p-v-o-s/olm-pstat/README.md

Potentiostat module for the Open Lab Monitor
