p-v-o-s/olm-pstat/test/JSpstat_10k_2probe.csv

#Starting Voltage (mV-1800mV)
#1800.00
#Ending Voltage (mV-1800mV)
#0.00
#Scan Rate in mV/sec (sec)
#100
#Pre-concentration time (sec)
#1
#Mode (0:ASV, 1:CV)
#2
#&
0.0355 | 0.0000
0.0198 | 0.0000
0.0216 | 0.0000
0.0224 | 0.0000
0.0233 | 0.0000
0.0276 | 0.0000
0.0042 | 0.0000
0.0077 | 0.0000
0.0146 | 0.0000
-0.0106 | 0.0000
-0.0097 | 0.0000
-0.0184 | 0.0000
-0.0262 | 0.0000
-0.0141 | 0.0000
-0.0184 | 0.0000
-0.0332 | 0.0000
-0.0349 | 0.0000
-0.0349 | 0.0000
-0.0427 | 0.0000
-0.0427 | 0.0000
-0.0575 | 0.0000
-0.0627 | 0.0000
-0.0532 | 0.0000
-0.0627 | 0.0000
-0.0523 | 0.0000
-0.0618 | 0.0000
-0.0705 | 0.0000
-0.0627 | 0.0000
-0.0792 | 0.0000
-0.0827 | 0.0000
-0.0940 | 0.0000
-0.0853 | 0.0000
-0.0957 | 0.0000
-0.0948 | 0.0000
-0.0992 | 0.0000
-0.1018 | 0.0000
-0.1053 | 0.0000
-0.0966 | 0.0000
-0.0992 | 0.0000
-0.1140 | 0.0000
-0.1244 | 0.0000
-0.1053 | 0.0000
-0.1183 | 0.0000
-0.1339 | 0.0000
-0.1270 | 0.0000
-0.1270 | 0.0000
-0.1435 | 0.0000
-0.1383 | 0.0000
-0.1400 | 0.0000
-0.1591 | 0.0000
-0.1643 | 0.0000
-0.1522 | 0.0000
-0.1695 | 0.0000
-0.1626 | 0.0000
-0.1722 | 0.0000
-0.1617 | 0.0000
-0.1748 | 0.0000
-0.1826 | 0.0000
-0.1678 | 0.0000
-0.1765 | 0.0000
-0.1756 | 0.0000
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
