p-v-o-s/olm-pstat/test/data/out.png

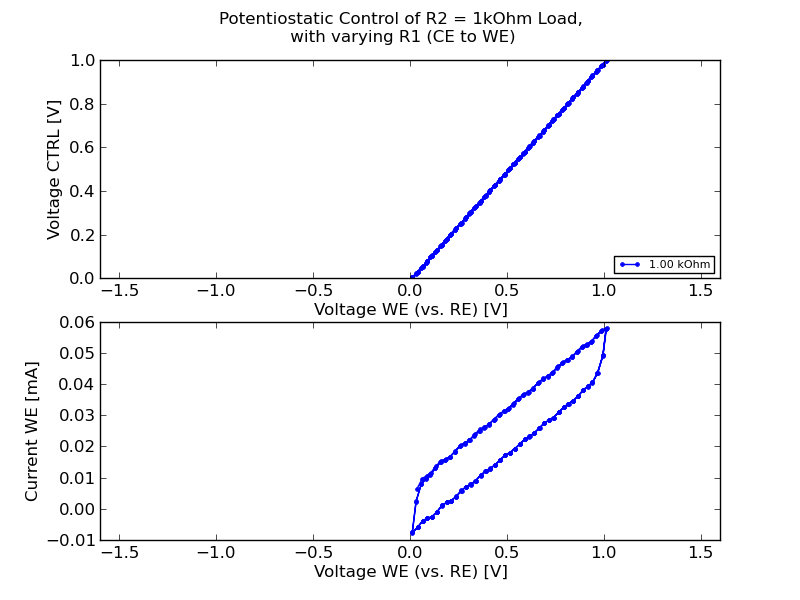
test/data/out.png
