p-v-o-s/olm-pstat/test/data/pstat_R2=1k_R1=0-2k.png

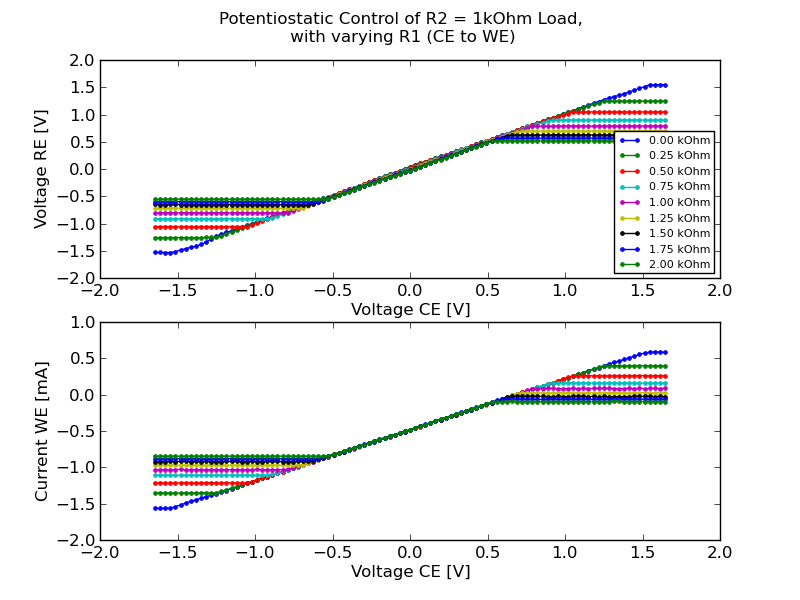
test/data/pstat_R2=1k_R1=0-2k.png
