p-v-o-s/olm-pstat/test/JSpstat_10k_2probe.png

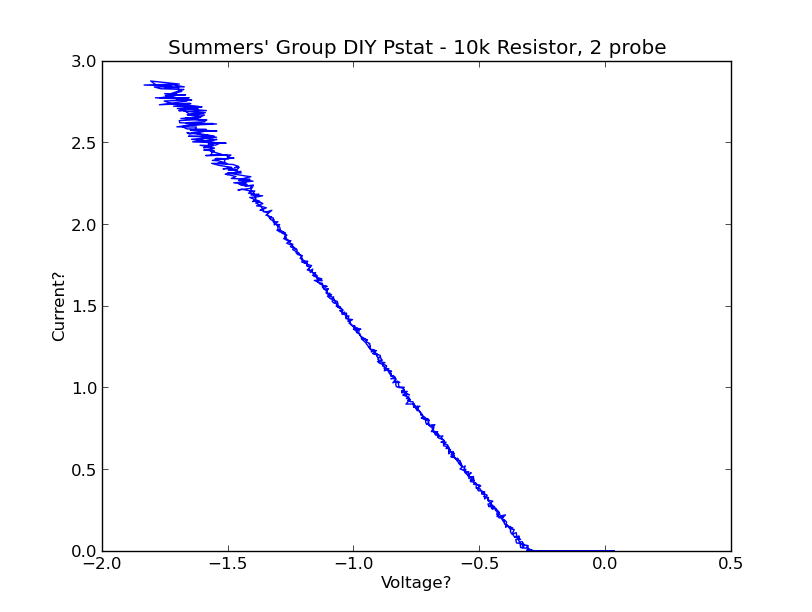
test/JSpstat_10k_2probe.png
