p-v-o-s/olm-pstat/test/MCP4161-104E-P_Resistance_vs_Ntap.png

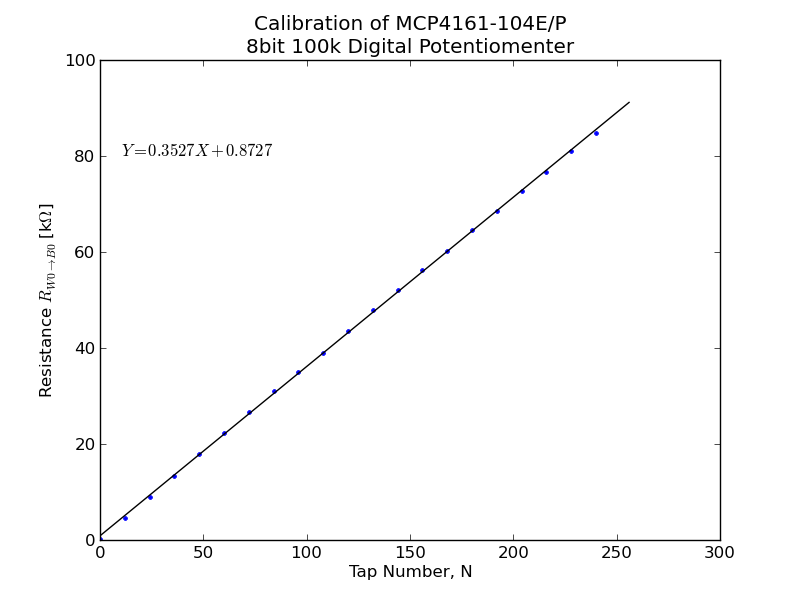
test/MCP4161-104E-P_Resistance_vs_Ntap.png
