p-v-o-s/olm-pstat/test/data/out.pdf

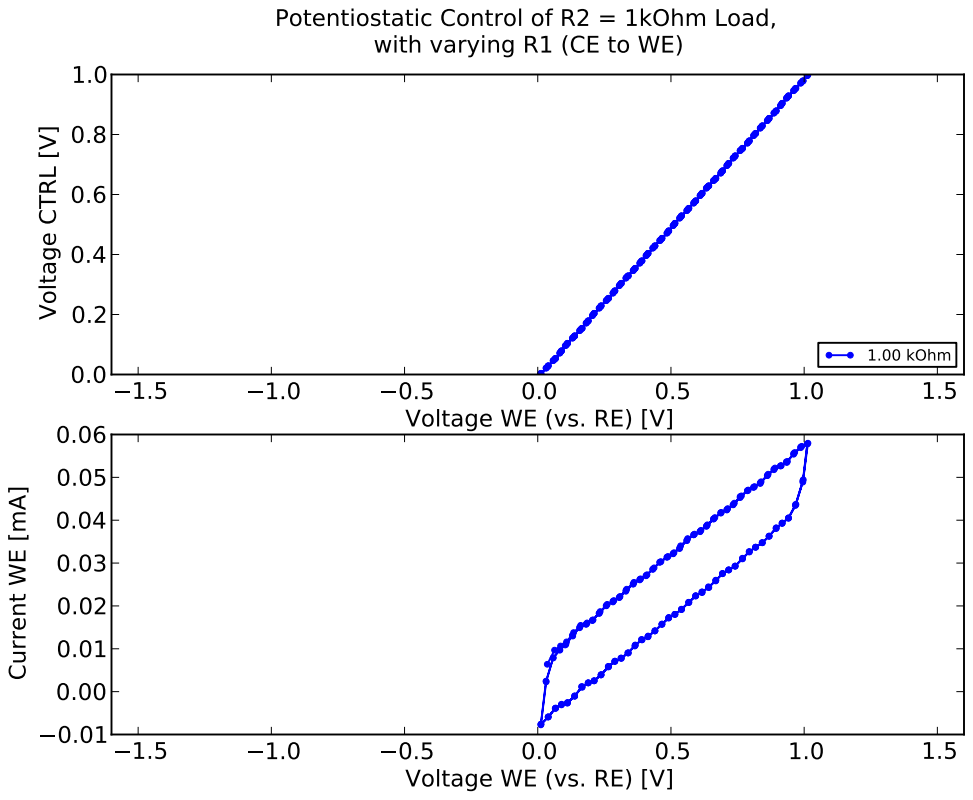
[picture p8: page 1]
Voltage CTRL [V]; 1.00 kOhm

Potentiostatic Control of R2 = 1kOhm Load,

with varying R1 (CE to WE)

Voltage WE (vs. RE) [V]

Current WE [mA]
