p-v-o-s/olm-pstat/test/data/pstat_R2=1k_R1=0-2k.pdf

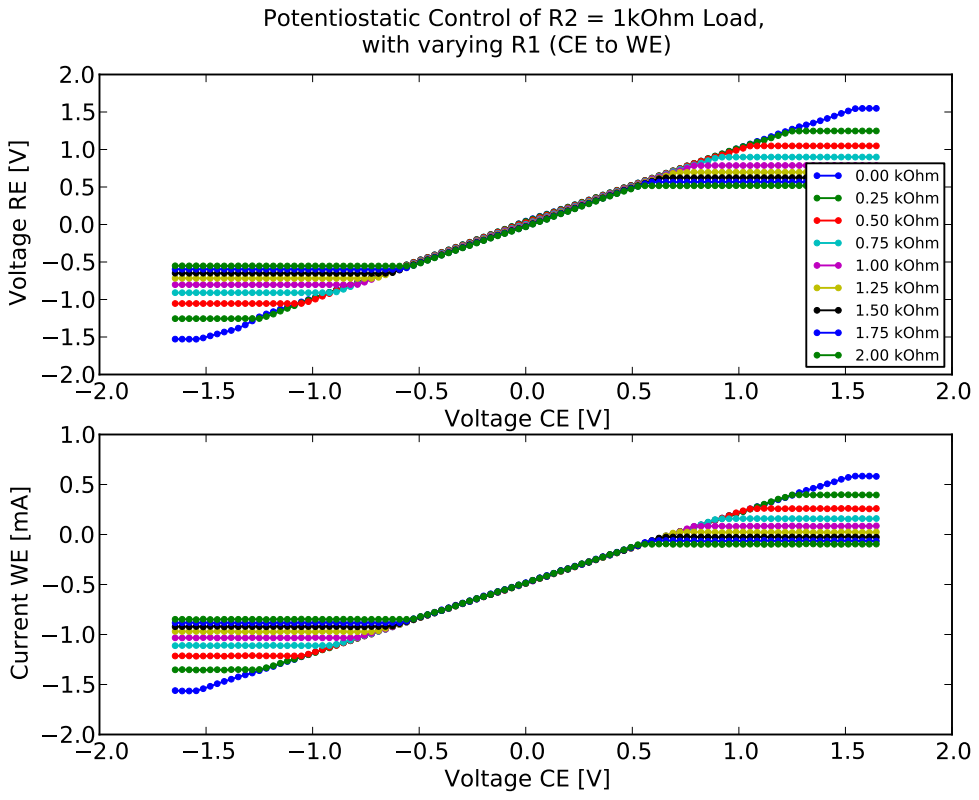
[picture p9: page 1]
Voltage CE [V]; Voltage RE [V]; 0.00 kOhm; 0.25 kOhm; 0.50 kOhm; 0.75 kOhm; 1.00 kOhm; 1.25 kOhm; 1.50 kOhm; 1.75 kOhm; 2.00 kOhm

Potentiostatic Control of R2 = 1kOhm Load,

with varying R1 (CE to WE)

Current WE [mA]
