p-v-o-s/olm-pstat/doc/jsummers/PDIP-Potentiostat-14.brd

## EAGLE design doc/jsummers/PDIP-Potentiostat-14.brd (2013-08-27)

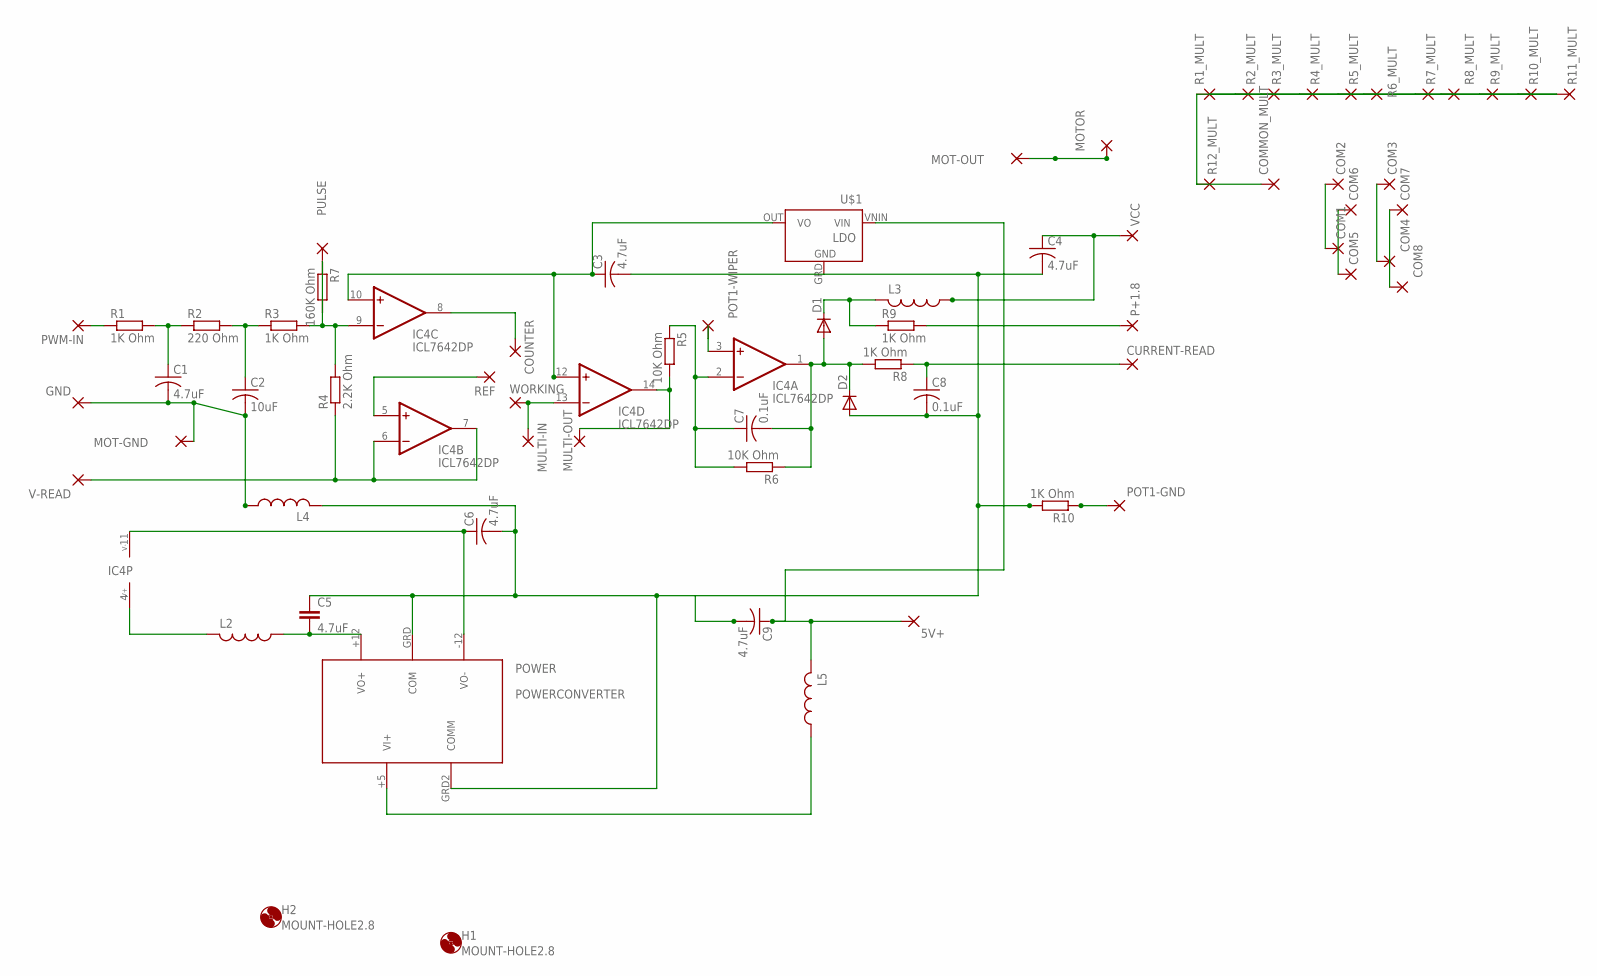
[picture p12: schematic PDIP-Potentiostat-14.sch]

Parts:
5V+: 1,6/0,9
C1, C3, C4, C5, C6, C9: 4.7uF; C025-050X050
C2: 10uF; C025-050X050
C7, C8: 0.1uF; C025-050X050
COM1, COM2, COM3, COM4, COM5, COM6, COM7, COM8: 1,6/0,9
COMMON_MULT: 1,6/0,9
COUNTER: 1,6/0,9
CURRENT-READ: 1,6/0,9
D1, D2: DIODE-D-7.5; D-7.5
GND: 1,6/0,9
H1, H2: MOUNT-HOLE2.8; 2,8
IC4: ICL7642DP; DIL14
L2, L3, L4, L5: L-USTFI0305; TFI0305
MOT-GND: 1,6/0,9
MOT-OUT: 1,6/0,9
MOTOR: 1,6/0,9
MULTI-IN: 1,6/0,9
MULTI-OUT: 1,6/0,9
P+1.8: 1,6/0,9
POT1-GND, POT1-WIPER: 1,6/0,9
POWER: POWERCONVERTER; HMM2
PULSE: 1,6/0,9
PWM-IN: 1,6/0,9
R1, R3, R8, R9, R10: 1K Ohm; 0204/7
R1_MULT, R2_MULT, R3_MULT, R4_MULT, R5_MULT, R6_MULT, R7_MULT, R8_MULT, R9_MULT, R10_MULT, R11_MULT, R12_MULT: 1,6/0,9
R2: 220 Ohm; 0204/7
R4: 2.2K Ohm; 0204/7
R5, R6: 10K Ohm; 0204/7
R7: 160K Ohm; 0204/7
REF: 1,6/0,9
U$1: LDO
V-READ: 1,6/0,9
VCC: 1,6/0,9
WORKING: 1,6/0,9

Connections:
+5V: D1.C, L3.2, R9.1
unnamed: L5.1, POWER.+5 (VI+)
unnamed: IC4.6 (-IN), IC4.7 (OUT), R4.1, V-READ.1
unnamed: IC4.5 (+IN), REF.1
unnamed: 5V+.1, C9.1, L5.2, U$1.VNIN (VIN)
unnamed: COUNTER.1, IC4.8 (OUT)
unnamed: IC4.14 (OUT), MULTI-OUT.1, R5.2
unnamed: C7.1, IC4.2 (-IN), R5.1, R6.2
unnamed: IC4.4 (V+), L2.2
unnamed: PWM-IN.1, R1.1
unnamed: IC4.9 (-IN), R3.2, R4.2, R7.2
unnamed: C3.2, C4.2, C5.1, C6.2, C8.2, C9.2, D2.A, L4.2, POWER.GRD (COM), POWER.GRD2 (COMM), R10.2, U$1.GRD (GND)
unnamed: PULSE.1, R7.1
unnamed: C1.1, R1.2, R2.1
unnamed: IC4.3 (+IN), POT1-WIPER.1
unnamed: C1.2, C2.2, GND.1, L4.1, MOT-GND.1
unnamed: C5.2, L2.1, POWER.+12 (VO+)
unnamed: IC4.13 (-IN), MULTI-IN.1, WORKING.1
unnamed: P+1.8.1, R9.2
unnamed: C2.1, R2.2, R3.1
unnamed: C7.2, D1.A, D2.C, IC4.1 (OUT), R6.1, R8.2
unnamed: COM3.1, COM4.1
unnamed: C3.1, IC4.10 (+IN), IC4.12 (+IN), U$1.OUT (VO)
unnamed: MOT-OUT.1, MOTOR.1
unnamed: C6.1, IC4.11 (V-), POWER.-12 (VO-)
unnamed: C8.1, CURRENT-READ.1, R8.1
unnamed: C4.1, L3.1, VCC.1
unnamed: POT1-GND.1, R10.1
unnamed: COM1.1, COM2.1
unnamed: COM7.1, COM8.1
unnamed: COM5.1, COM6.1
unnamed: COMMON_MULT.1, R1_MULT.1, R2_MULT.1, R3_MULT.1, R4_MULT.1, R5_MULT.1, R6_MULT.1, R7_MULT.1, R8_MULT.1, R9_MULT.1, R10_MULT.1, R11_MULT.1, R12_MULT.1

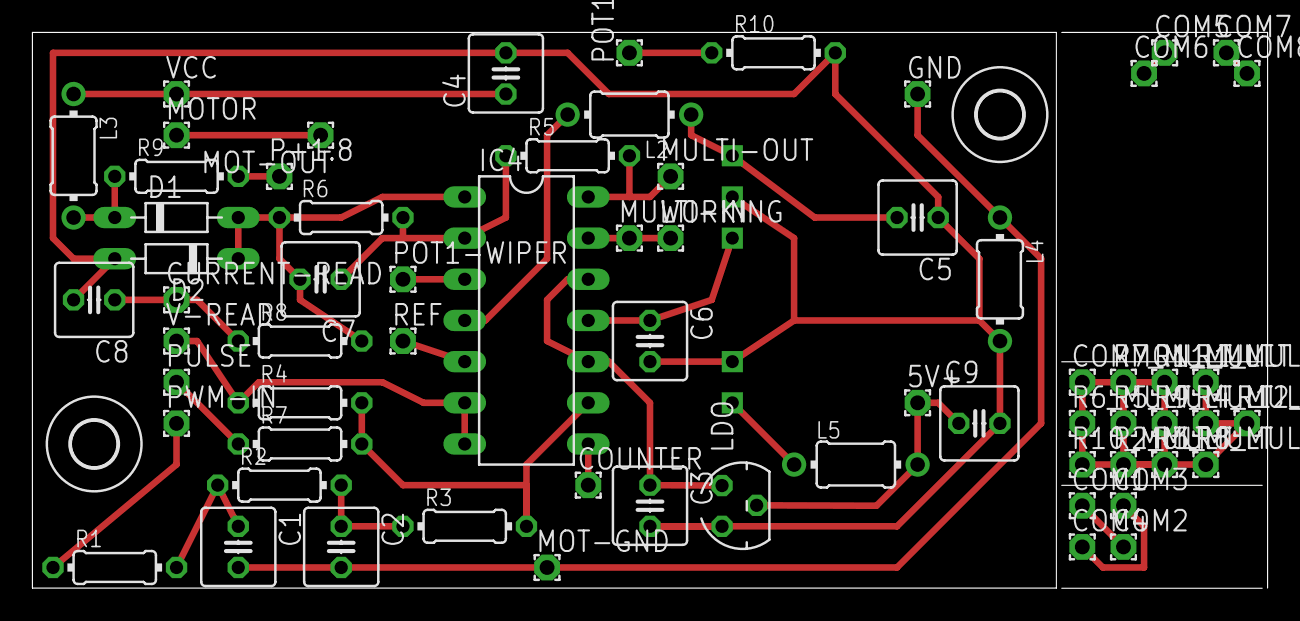
[picture p13: board PDIP-Potentiostat-14.brd from above]

Board: 2 copper layers, 76.2 x 34.3 mm, 69 parts (0 on the bottom side), 32 nets.
