p-v-o-s/olm-pstat/(commit log)

2013-05-15 data set from test of Summers' Group DIY pstat
    [JSpstat_10k_2probe.csv]
2013-05-29 arduino firmware
    [MCP4901.fz]
2013-05-29 converted by Fritzing; custom part lost
    [MCP4921.fz, MCP4921.fzz]
2013-05-29 remove non-existent shutdown pin
2013-05-29 added class member for voltage reference
2013-08-09 ADC library functionality
2013-08-09 Test code for ADC and Dig Pot
2013-08-10 testing voltage control range
2013-08-13 added VCTRL command to set controlled voltage
2013-08-13 calibration of digital potentiometer
    [MCP4161-104E-P_Resistance_vs_Ntap.csv]
2013-08-13 Python code to plot voltage sweep test
2013-08-27 lots of added functionality and documentation
    [PDIP-Potentiostat-14.brd, PDIP-Potentiostat-14.sch]
2013-09-01 better voltage calibration; restored command functionality
2013-09-02 implemented current sensing range switching and autoranging functionality
2013-09-02 push device driver back under subpackages
2013-09-02 refactored into an Automat Device Interface
2013-09-02 added directory for configuration
    [testing.cfg]
2013-09-02 added example config
    [EXAMPLE.cfg]
2013-09-03 core functionality for the framework; template for Current vs. Voltage plot
2013-09-06 lots of changes; real-time CV implemented
    [testing.cfg]
